Marcel-Kitzbichler/OpenMoverPlatform/Skizzen/Fahrgestell_v1.png

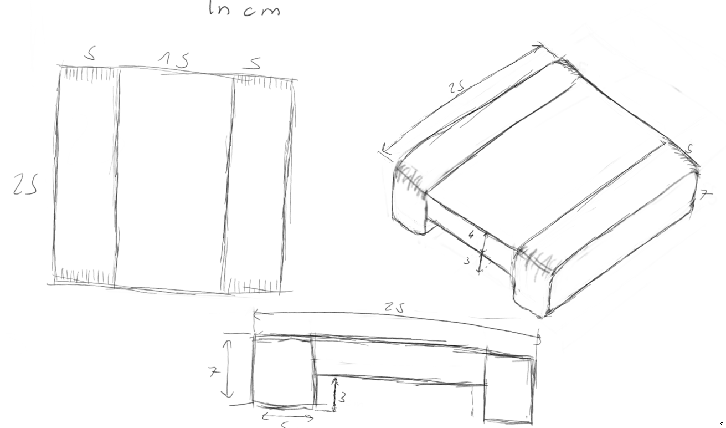
Skizzen/Fahrgestell_v1.png
