Marcel-Kitzbichler/OpenMoverPlatform/Mechanical/DRIVEUNIT_V2/UpperBearingAssembly.SLDASM

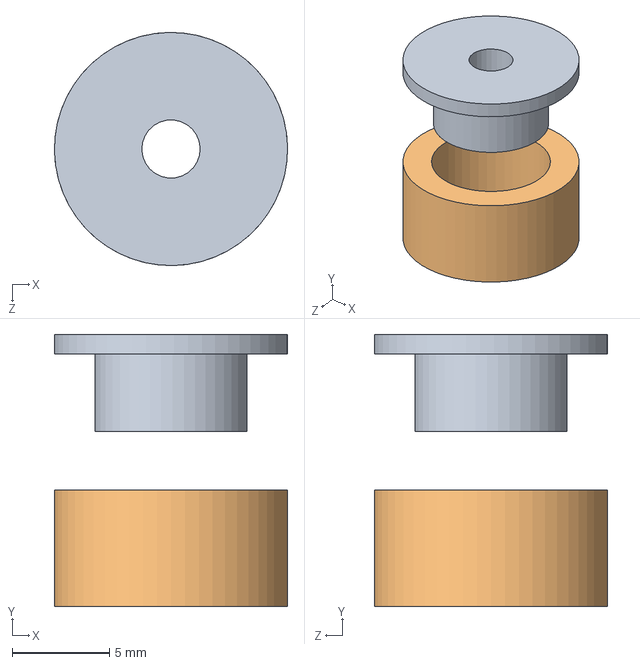
[picture p5: CAD file, 2026-01-29]
Mechanical/DRIVEUNIT_V2/UpperBearingAssembly.SLDASM
12.0 x 14.0 x 12.0 mm
UpperHolder
LowerHolder
