Marcel-Kitzbichler/OpenMoverPlatform/Mechanical/DRIVEUNIT_V2/ChainwheelAss.SLDASM

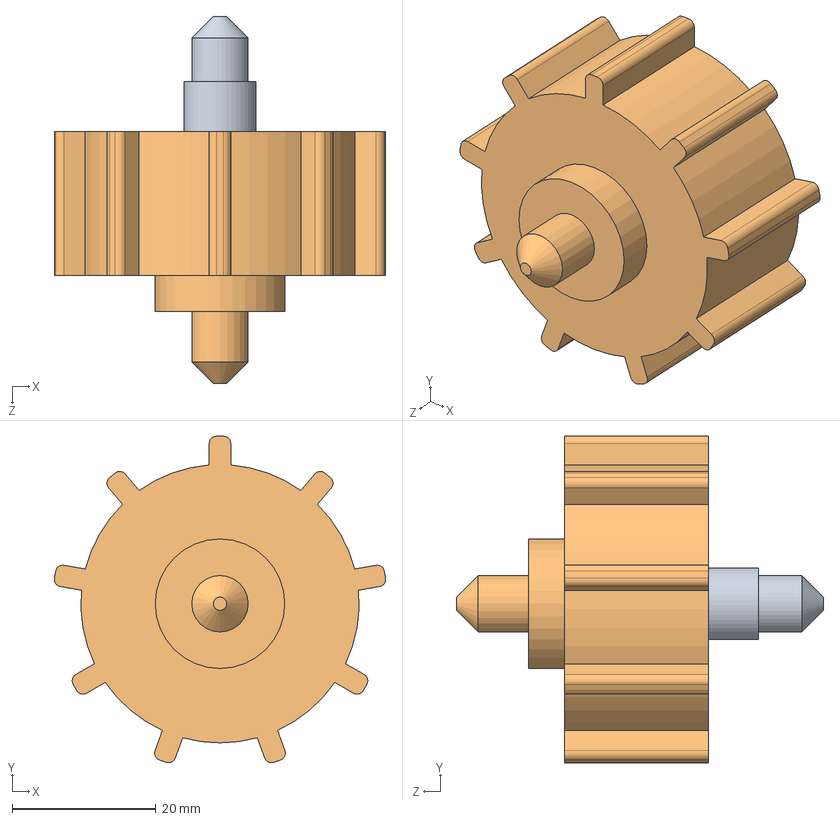
[picture p6: CAD file, 2026-01-29]
Mechanical/DRIVEUNIT_V2/ChainwheelAss.SLDASM
46.0 x 45.4 x 51.0 mm
Chainwheel
ChainAxle
