Marcel-Kitzbichler/OpenMoverPlatform/Mechanical/Assm.SLDASM

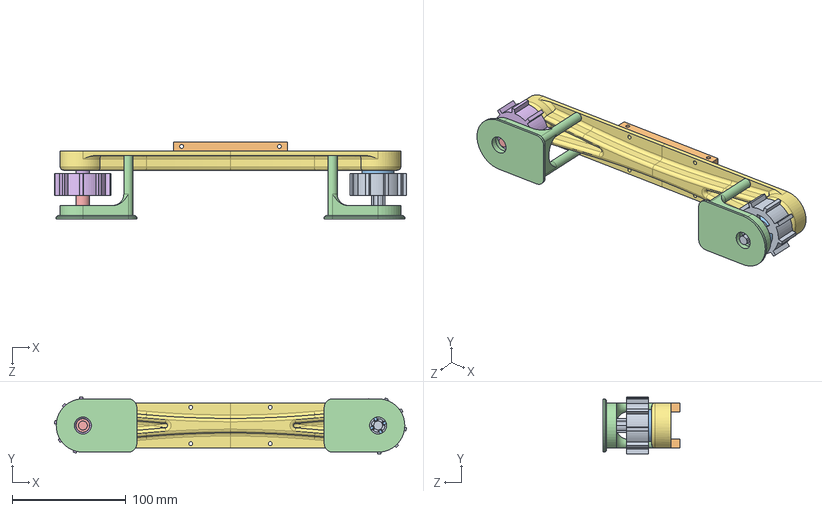
[picture p7: CAD file, 2026-01-29]
Mechanical/Assm.SLDASM
310.0 x 50.1 x 68.0 mm
Teil1
Wheel
Wheelaxle
WheelHolder x 2
MotorDummy
SideBrace x 2
Wheel_Drive
