Marcel-Kitzbichler/OpenMoverPlatform/Mechanical/Module Sample.SLDASM

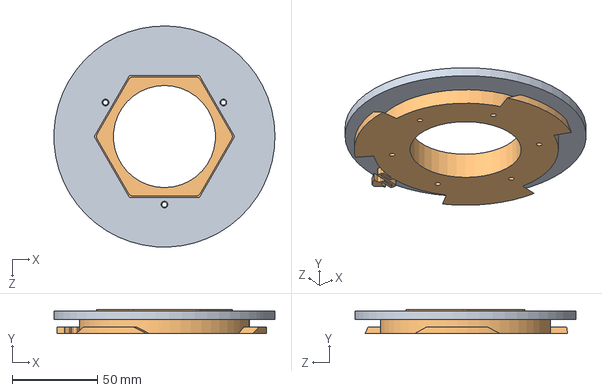
[picture p8: CAD file, 2026-01-29]
Mechanical/Module Sample.SLDASM
129.9 x 14.4 x 129.9 mm
Module Lower
Module Upper Blank
