Marcel-Kitzbichler/OpenMoverPlatform/Mechanical/DRIVEUNIT_V2/2ndWheel.SLDPRT

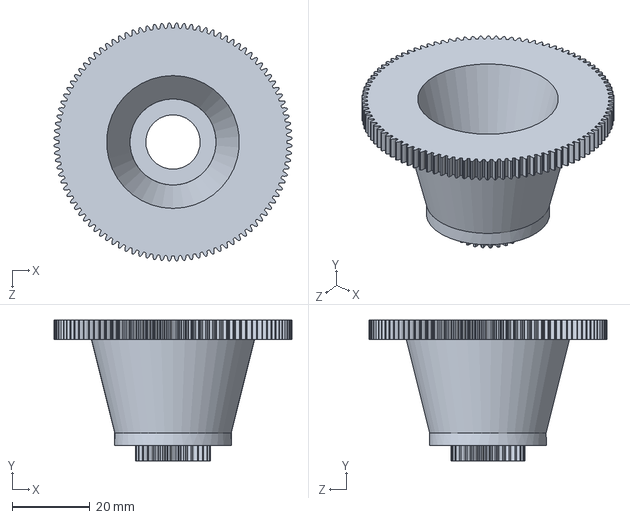
[picture p9: CAD file, 2026-01-29]
Mechanical/DRIVEUNIT_V2/2ndWheel.SLDPRT
61.2 x 36.2 x 61.2 mm
