Marcel-Kitzbichler/OpenMoverPlatform/Mechanical/Wheelaxle.SLDPRT

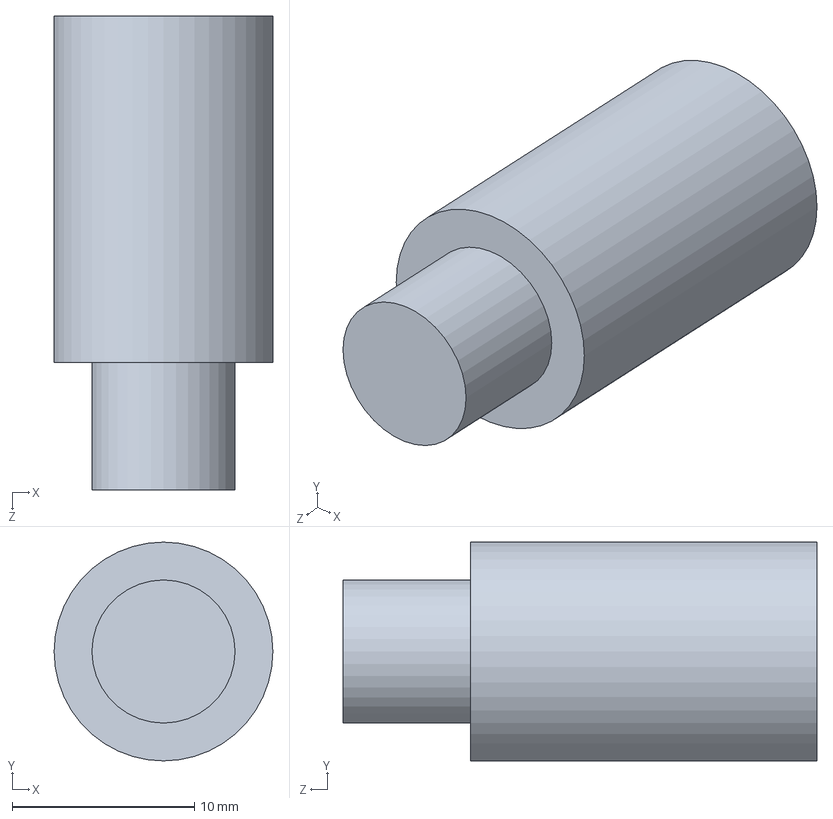
[picture p10: CAD file, 2026-01-29]
Mechanical/Wheelaxle.SLDPRT
12.0 x 12.0 x 26.0 mm
