Marcel-Kitzbichler/OpenMoverPlatform/Mechanical/DRIVEUNIT_V2/UpperHolder.SLDPRT

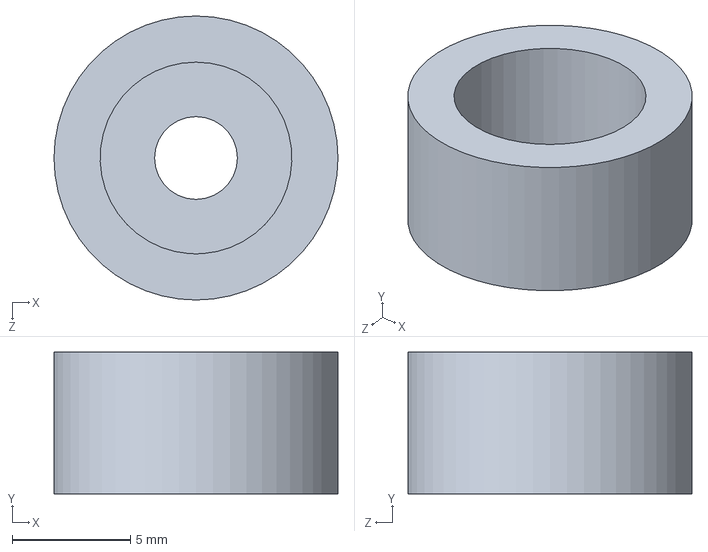
[picture p11: CAD file, 2026-01-29]
Mechanical/DRIVEUNIT_V2/UpperHolder.SLDPRT
12.0 x 6.00 x 12.0 mm
