Marcel-Kitzbichler/OpenMoverPlatform/Mechanical/Module Upper Blank.SLDPRT

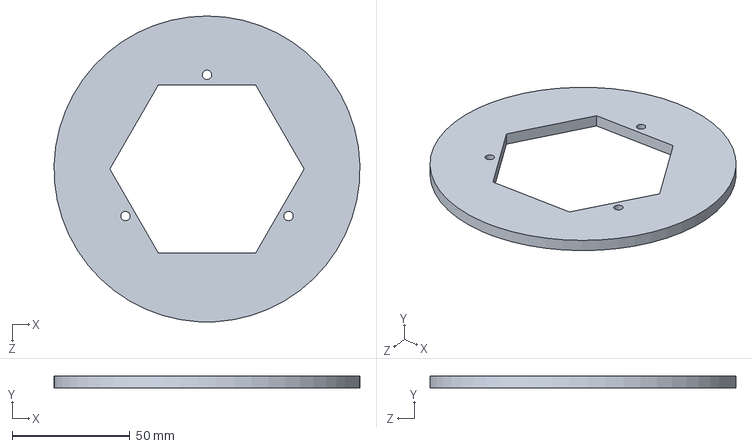
[picture p12: CAD file, 2026-01-29]
Mechanical/Module Upper Blank.SLDPRT
129.9 x 5.00 x 130.0 mm
