Marcel-Kitzbichler/OpenMoverPlatform/Mechanical/chainPresser.SLDPRT

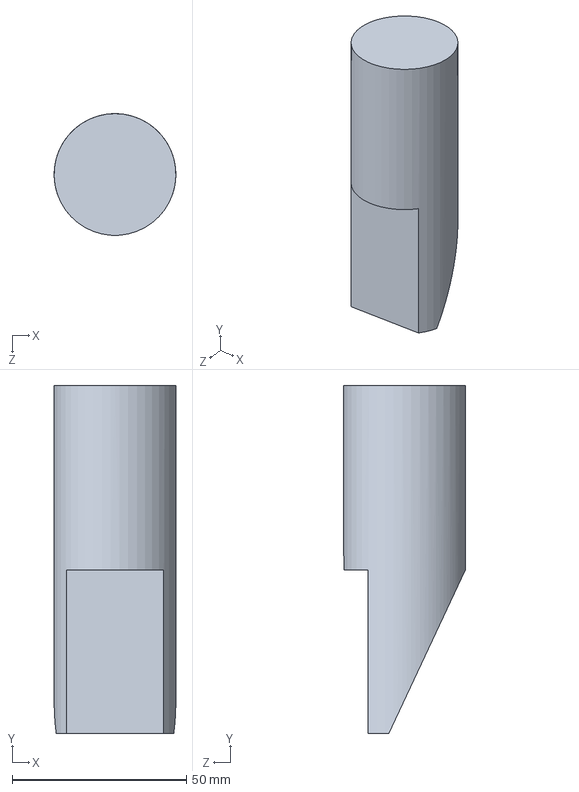
[picture p13: CAD file, 2026-01-29]
Mechanical/chainPresser.SLDPRT
35.0 x 100.0 x 35.0 mm
