Marcel-Kitzbichler/OpenMoverPlatform/Mechanical/DRIVEUNIT_V2/ChainAxle.SLDPRT

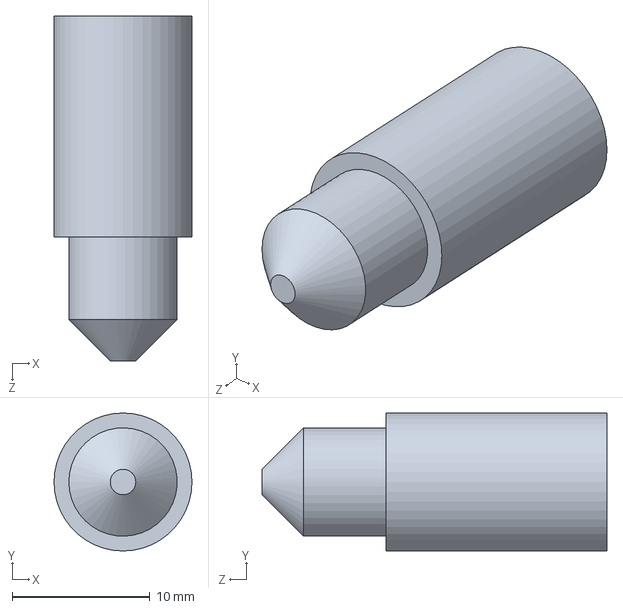
[picture p14: CAD file, 2026-01-29]
Mechanical/DRIVEUNIT_V2/ChainAxle.SLDPRT
10.0 x 10.0 x 25.0 mm
