Marcel-Kitzbichler/OpenMoverPlatform/Mechanical/DRIVEUNIT_V2/3rdGear.SLDPRT

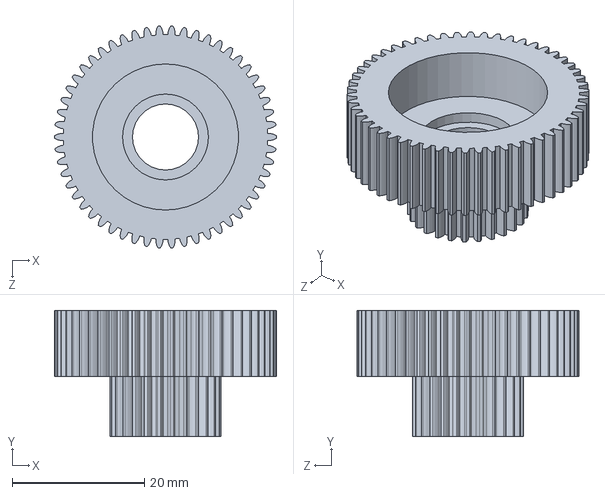
[picture p15: CAD file, 2026-01-29]
Mechanical/DRIVEUNIT_V2/3rdGear.SLDPRT
33.6 x 19.1 x 33.6 mm
