Marcel-Kitzbichler/OpenMoverPlatform/Mechanical/SideBrace.SLDPRT

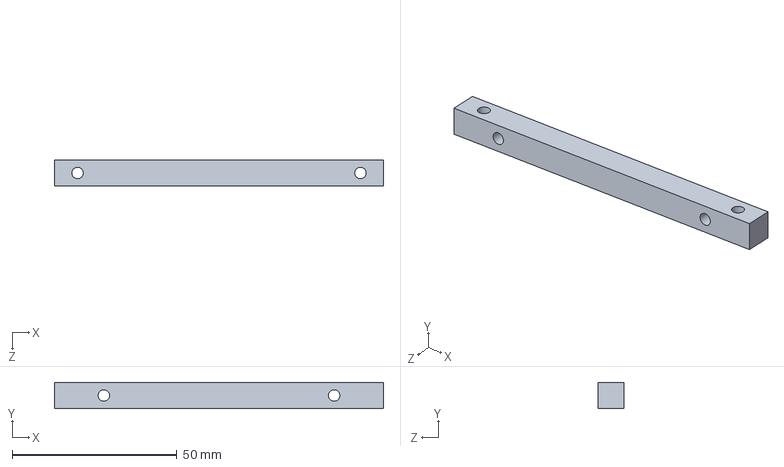
[picture p16: CAD file, 2026-01-29]
Mechanical/SideBrace.SLDPRT
100.0 x 8.00 x 8.00 mm
