Marcel-Kitzbichler/OpenMoverPlatform/Mechanical/Body2.SLDPRT

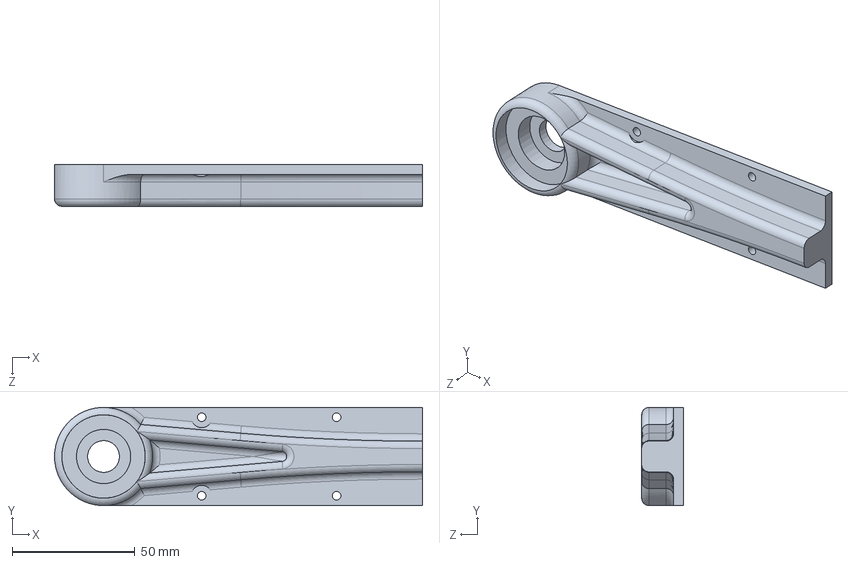
[picture p17: CAD file, 2026-01-29]
Mechanical/Body2.SLDPRT
150.0 x 40.0 x 17.0 mm
