Marcel-Kitzbichler/OpenMoverPlatform/Mechanical/DRIVEUNIT_V2/2ndGear.SLDPRT

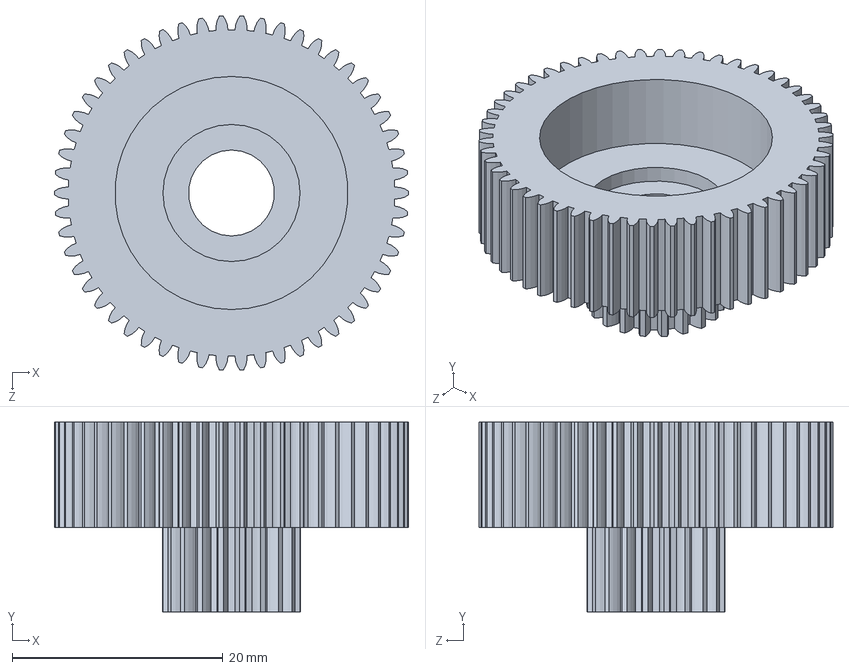
[picture p18: CAD file, 2026-01-29]
Mechanical/DRIVEUNIT_V2/2ndGear.SLDPRT
33.6 x 18.0 x 33.6 mm
