Marcel-Kitzbichler/OpenMoverPlatform/Mechanical/Cover plate.SLDPRT

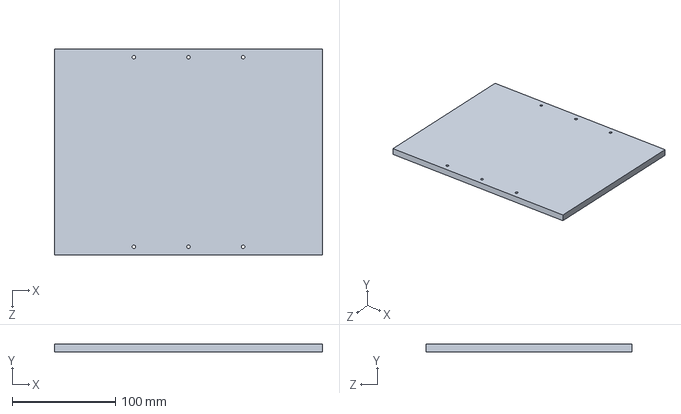
[picture p19: CAD file, 2026-01-29]
Mechanical/Cover plate.SLDPRT
260.0 x 8.00 x 200.0 mm
