Marcel-Kitzbichler/OpenMoverPlatform/Mechanical/DRIVEUNIT_V2/1stGear.SLDPRT

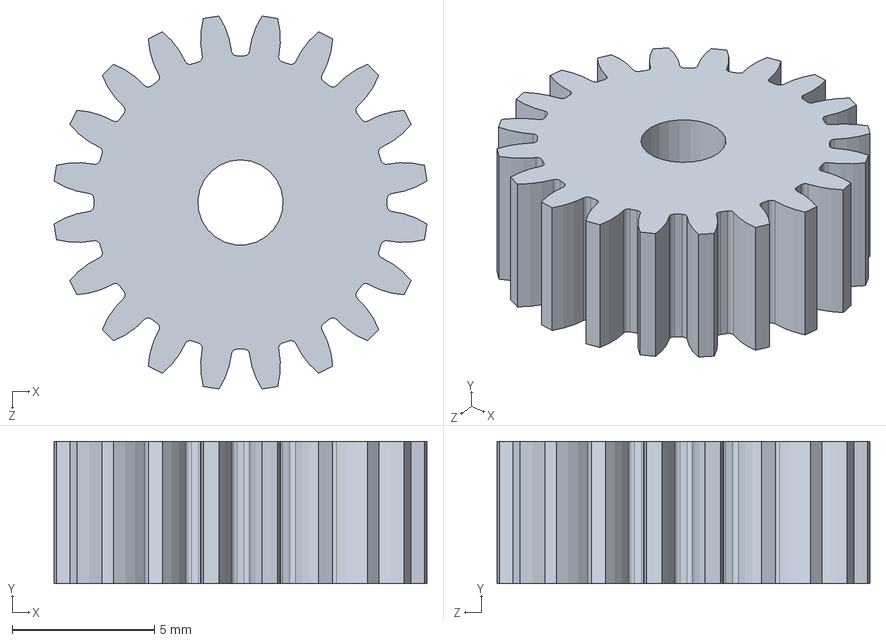
[picture p20: CAD file, 2026-01-29]
Mechanical/DRIVEUNIT_V2/1stGear.SLDPRT
13.1 x 5.00 x 13.1 mm
