Marcel-Kitzbichler/OpenMoverPlatform/Mechanical/MotorDummy.SLDPRT

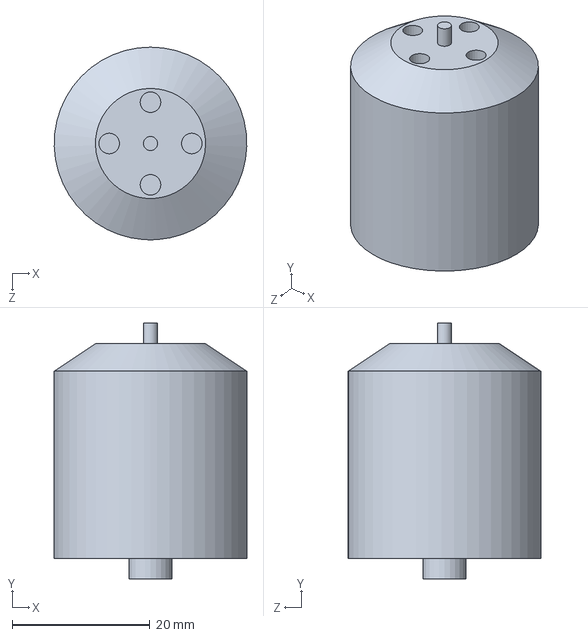
[picture p21: CAD file, 2026-01-29]
Mechanical/MotorDummy.SLDPRT
28.0 x 37.2 x 28.0 mm
