Marcel-Kitzbichler/OpenMoverPlatform/Mechanical/DRIVEUNIT_V2/Chainwheel.SLDPRT

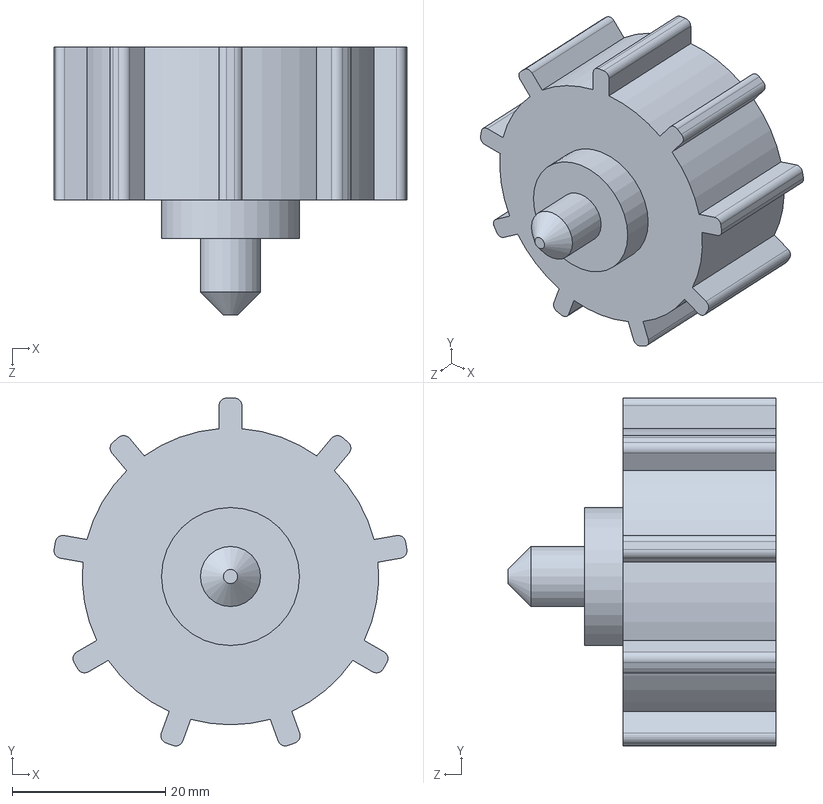
[picture p22: CAD file, 2026-01-29]
Mechanical/DRIVEUNIT_V2/Chainwheel.SLDPRT
46.0 x 45.4 x 35.0 mm
