Marcel-Kitzbichler/OpenMoverPlatform/Mechanical/Teil1.SLDPRT

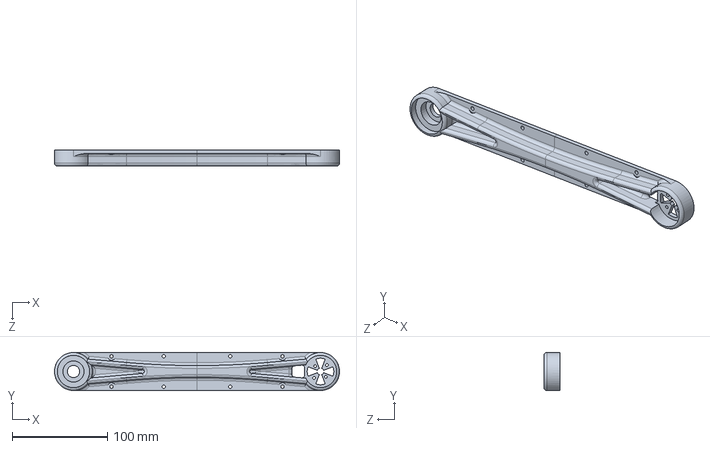
[picture p23: CAD file, 2026-01-29]
Mechanical/Teil1.SLDPRT
300.0 x 40.0 x 17.0 mm
