Marcel-Kitzbichler/OpenMoverPlatform/Mechanical/DRIVEUNIT_V2/coverplate.SLDPRT

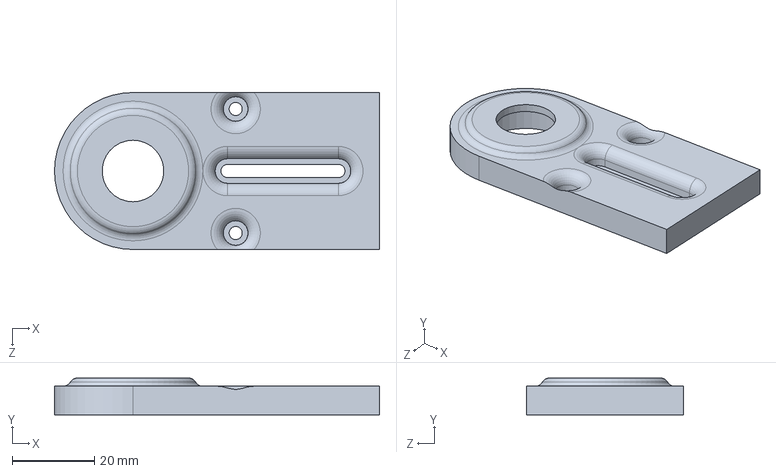
[picture p24: CAD file, 2026-01-29]
Mechanical/DRIVEUNIT_V2/coverplate.SLDPRT
79.1 x 9.00 x 38.2 mm
