Marcel-Kitzbichler/OpenMoverPlatform/Mechanical/WheelMastSupport.SLDPRT

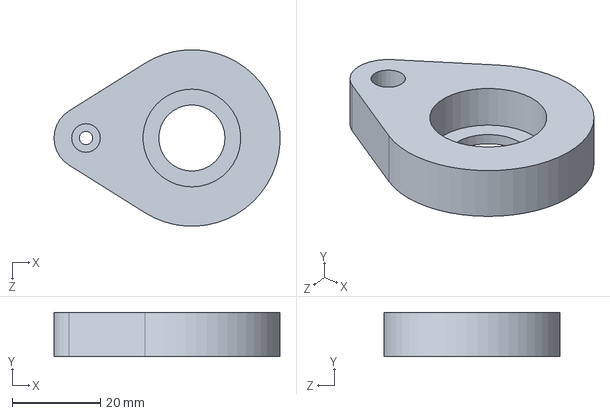
[picture p25: CAD file, 2026-01-29]
Mechanical/WheelMastSupport.SLDPRT
51.2 x 10.0 x 40.0 mm
