Marcel-Kitzbichler/OpenMoverPlatform/Mechanical/UpperPlate.SLDPRT

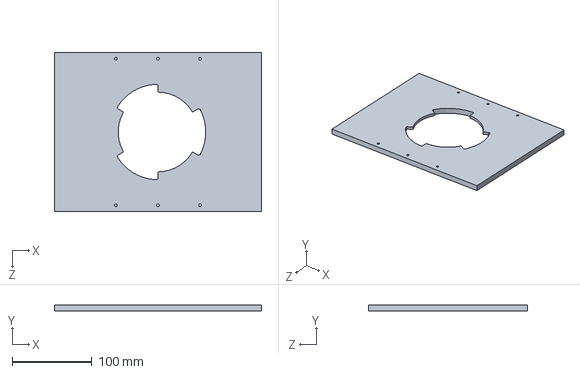
[picture p26: CAD file, 2026-01-29]
Mechanical/UpperPlate.SLDPRT
260.0 x 8.00 x 200.0 mm
