Marcel-Kitzbichler/OpenMoverPlatform/Mechanical/DRIVEUNIT_V2/Grundplatte.SLDPRT

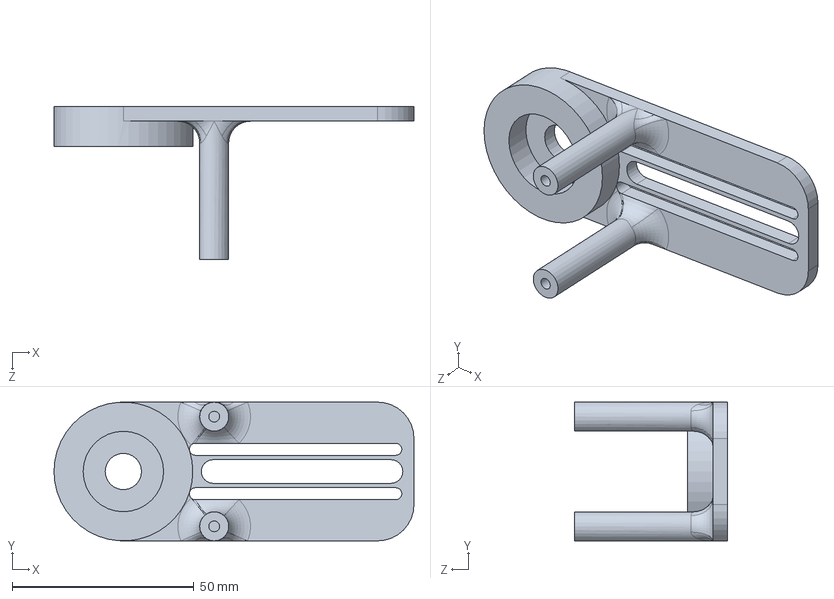
[picture p27: CAD file, 2026-01-29]
Mechanical/DRIVEUNIT_V2/Grundplatte.SLDPRT
99.1 x 38.2 x 42.0 mm
