Marcel-Kitzbichler/OpenMoverPlatform/Mechanical/DRIVEUNIT_V2/1stWheel.SLDPRT

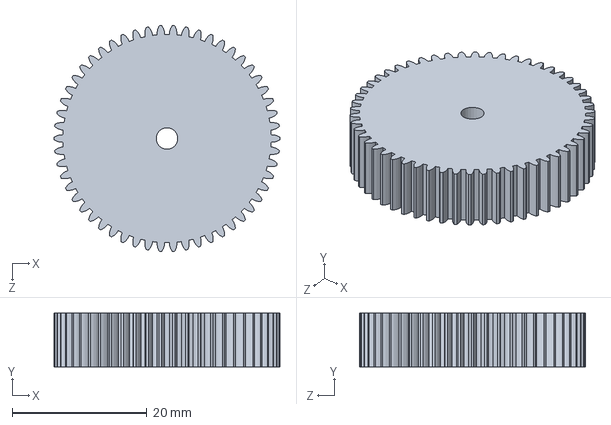
[picture p28: CAD file, 2026-01-29]
Mechanical/DRIVEUNIT_V2/1stWheel.SLDPRT
33.6 x 8.00 x 33.6 mm
