Marcel-Kitzbichler/OpenMoverPlatform/Mechanical/DRIVEUNIT_V2/FrontCover.SLDPRT

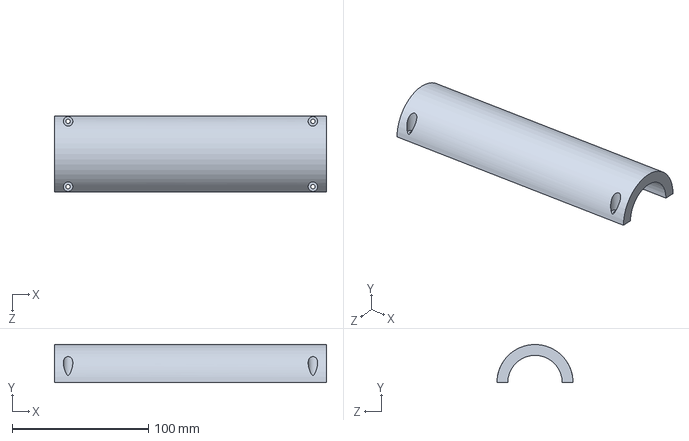
[picture p29: CAD file, 2026-01-29]
Mechanical/DRIVEUNIT_V2/FrontCover.SLDPRT
200.0 x 28.0 x 56.0 mm
