Marcel-Kitzbichler/OpenMoverPlatform/Mechanical/DRIVEUNIT_V2/LowerHolder.SLDPRT

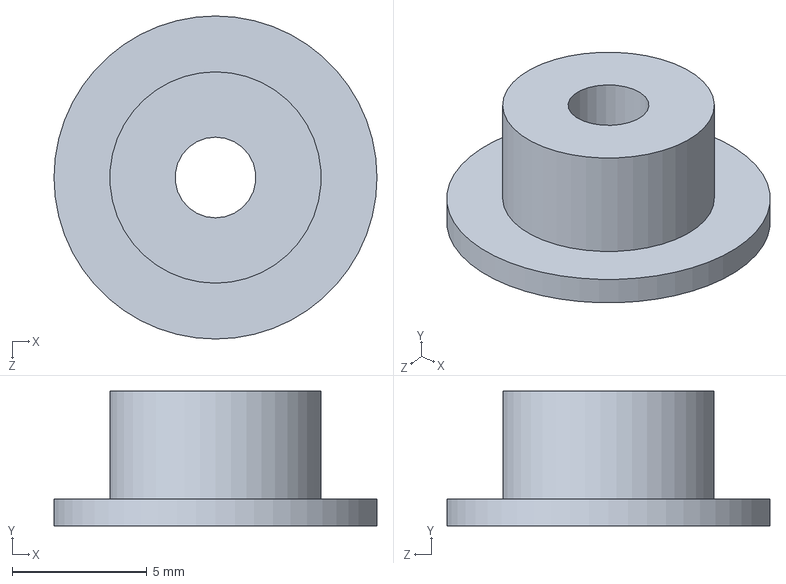
[picture p30: CAD file, 2026-01-29]
Mechanical/DRIVEUNIT_V2/LowerHolder.SLDPRT
12.0 x 5.00 x 12.0 mm
