Marcel-Kitzbichler/OpenMoverPlatform/Mechanical/WheelHolder.SLDPRT

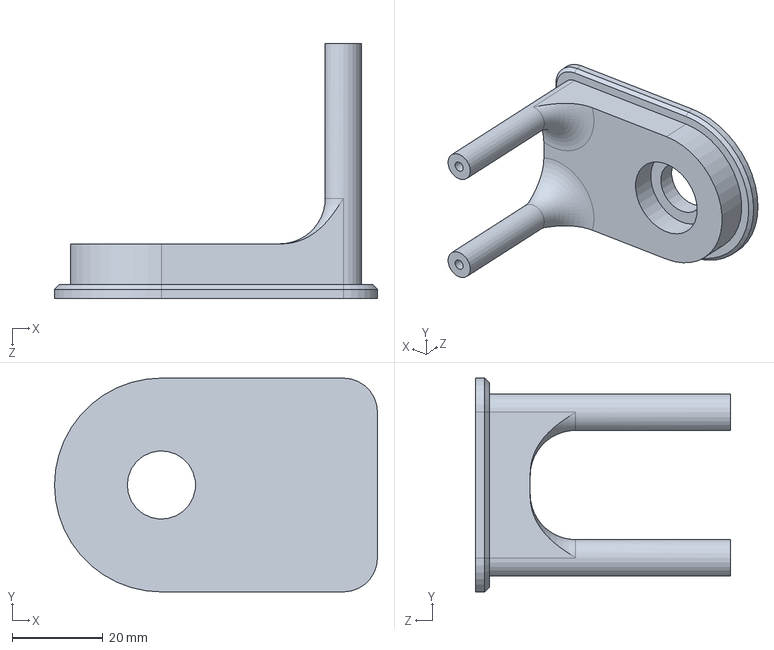
[picture p31: CAD file, 2026-01-29]
Mechanical/WheelHolder.SLDPRT
71.0 x 47.0 x 56.0 mm
