Marcel-Kitzbichler/OpenMoverPlatform/Mechanical/DRIVEUNIT_V2/Chaingear.SLDPRT

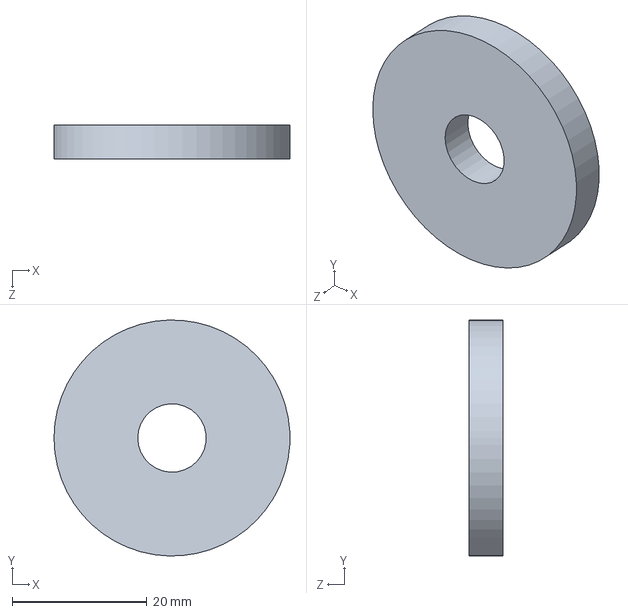
[picture p32: CAD file, 2024-11-21]
Mechanical/DRIVEUNIT_V2/Chaingear.SLDPRT
35.0 x 35.0 x 5.00 mm
