Marcel-Kitzbichler/OpenMoverPlatform/Mechanical/WheelMastStud.SLDPRT

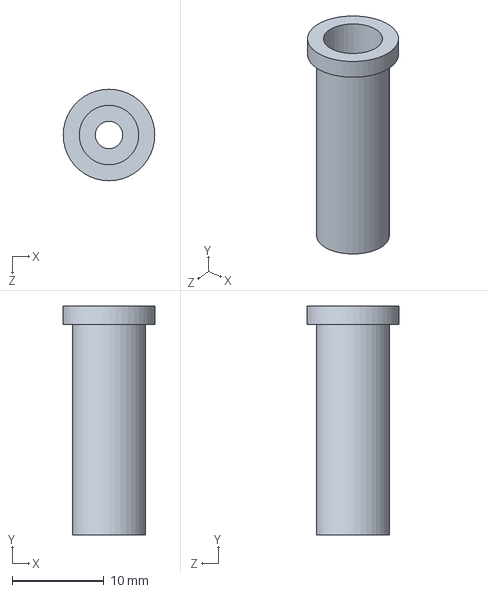
[picture p33: CAD file, 2026-01-29]
Mechanical/WheelMastStud.SLDPRT
10.0 x 25.0 x 10.0 mm
