Marcel-Kitzbichler/OpenMoverPlatform/Mechanical/Wheel.SLDPRT

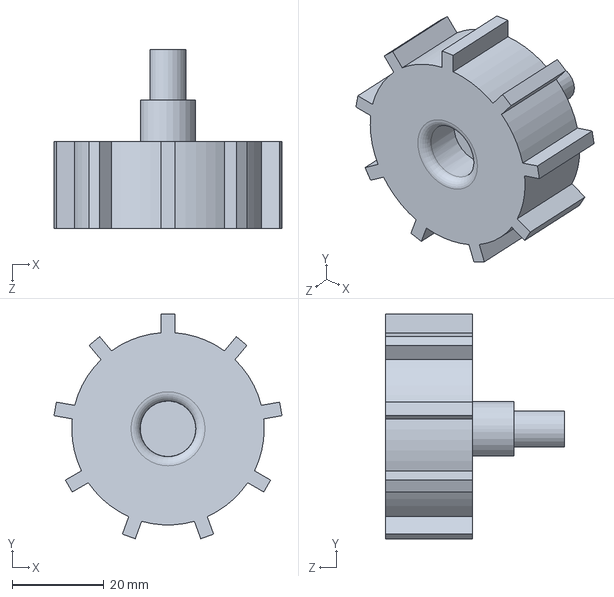
[picture p34: CAD file, 2026-01-29]
Mechanical/Wheel.SLDPRT
49.8 x 49.0 x 39.0 mm
