Marcel-Kitzbichler/OpenMoverPlatform/Mechanical/WheelMast.SLDPRT

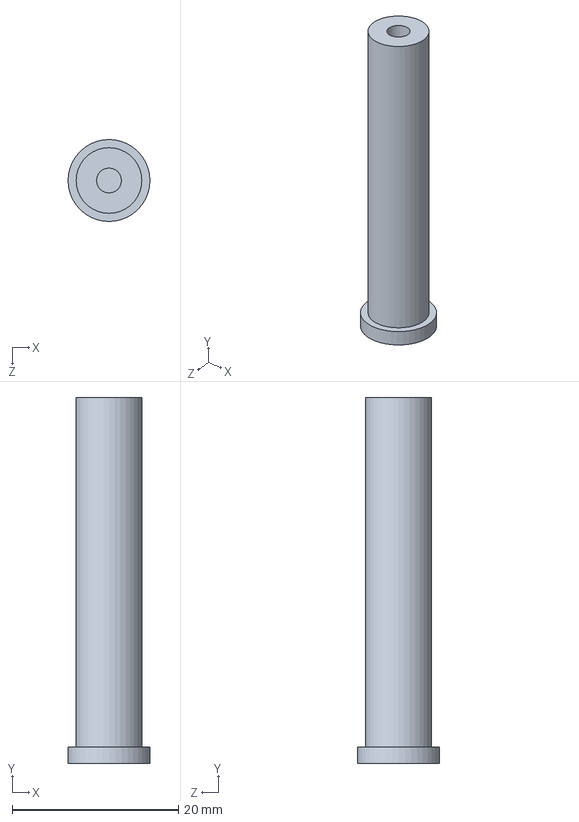
[picture p35: CAD file, 2026-01-29]
Mechanical/WheelMast.SLDPRT
9.85 x 44.0 x 9.85 mm
