Marcel-Kitzbichler/OpenMoverPlatform/Mechanical/Wheel_Drive.SLDPRT

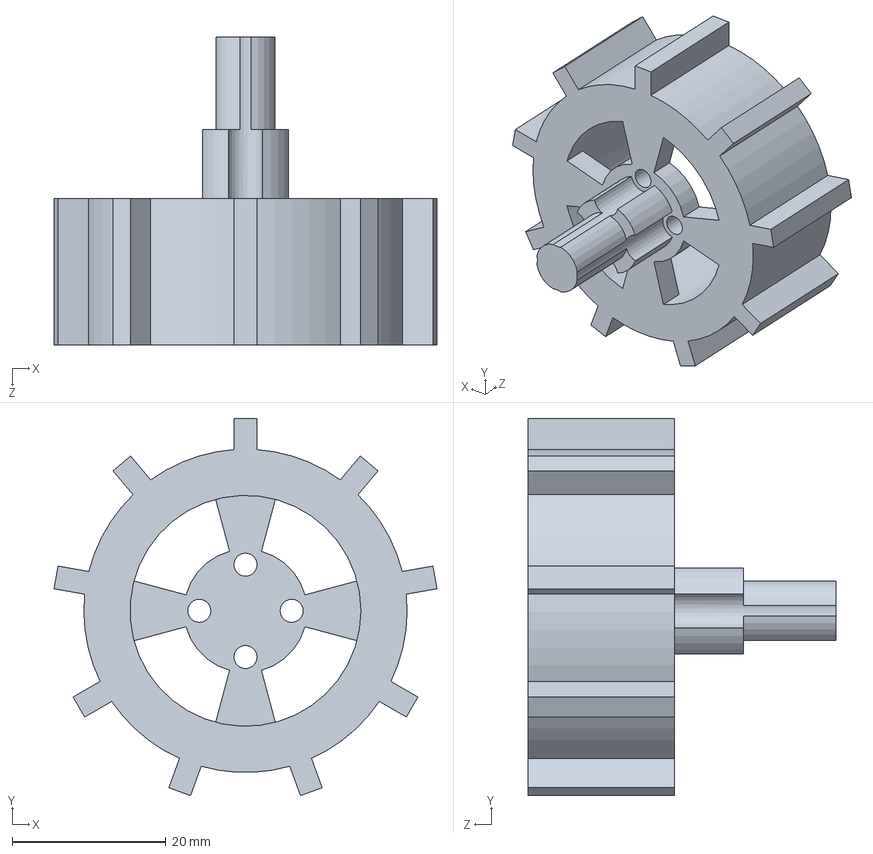
[picture p36: CAD file, 2026-01-29]
Mechanical/Wheel_Drive.SLDPRT
49.8 x 49.0 x 40.0 mm
