Marcel-Kitzbichler/OpenMoverPlatform/Mechanical/Module Lower.SLDPRT

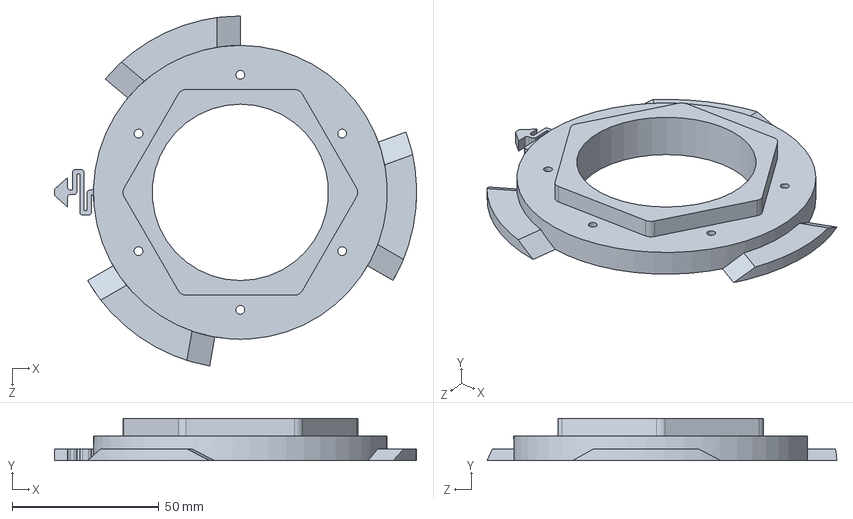
[picture p37: CAD file, 2025-05-10]
Mechanical/Module Lower.SLDPRT
123.3 x 14.4 x 119.1 mm
