Marcel-Kitzbichler/OpenMoverPlatform/Mechanical/Panzerketten 2.SLDPRT

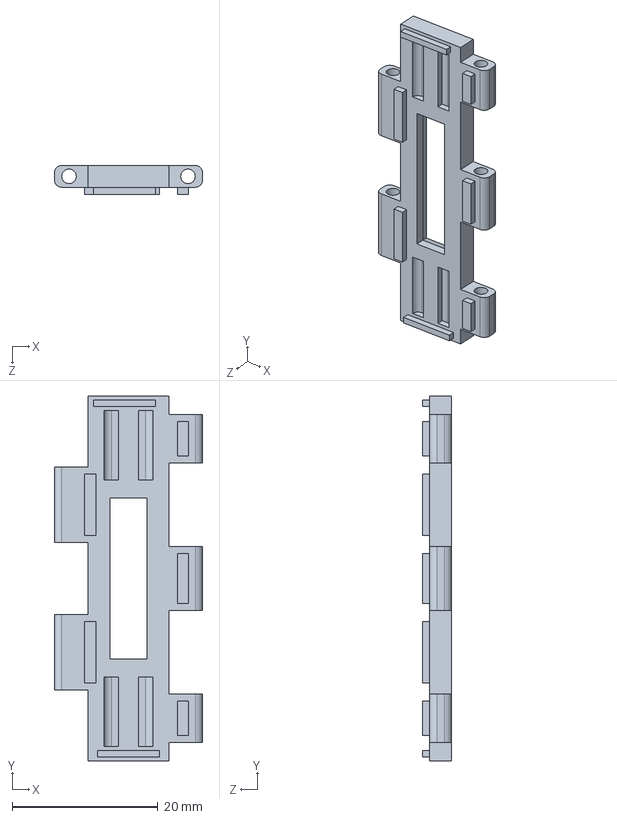
[picture p38: CAD file, 2025-02-27]
Mechanical/Panzerketten 2.SLDPRT
20.3 x 50.0 x 4.00 mm
