Marcel-Kitzbichler/OpenMoverPlatform/Mechanical/threadedRodM3x210.SLDPRT

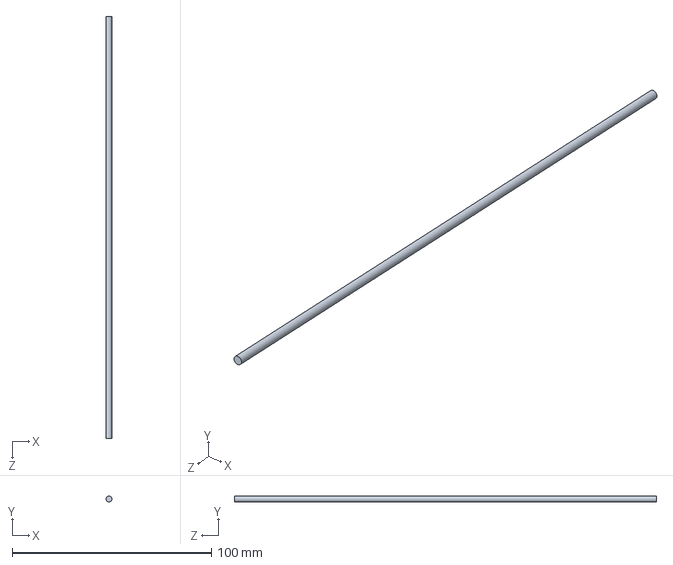
[picture p39: CAD file, 2025-01-20]
Mechanical/threadedRodM3x210.SLDPRT
3.00 x 3.00 x 212.0 mm
