Marcel-Kitzbichler/OpenMoverPlatform/Mechanical/3rdWheel.SLDPRT

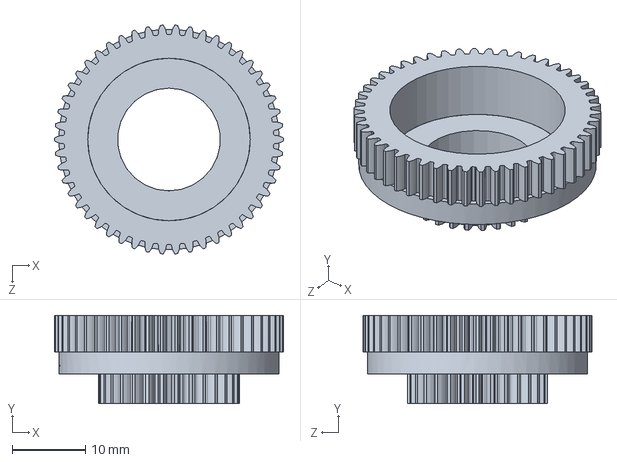
[picture p40: CAD file, 2024-12-03]
Mechanical/3rdWheel.SLDPRT
31.2 x 12.0 x 31.2 mm
