Marcel-Kitzbichler/OpenMoverPlatform/Mechanical/DRIVEUNIT_V2/Assembly.SLDASM

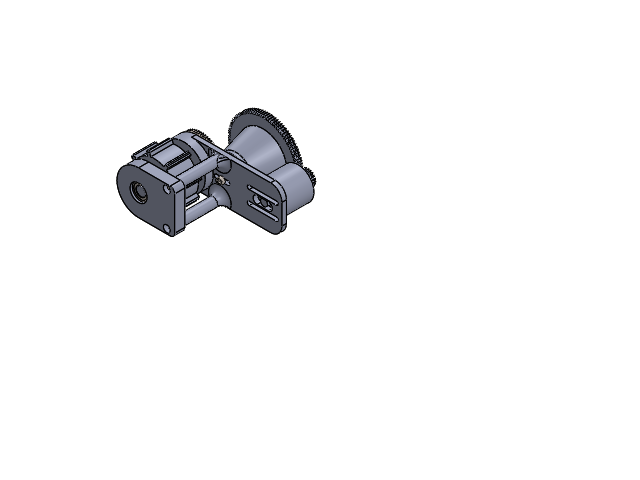
[picture p41: CAD file, 2026-01-29]
Mechanical/DRIVEUNIT_V2/Assembly.SLDASM
Grundplatte
radial ball bearing_68_din x 3
Chainwheel
ChainAxle
coverplate
UpperHolder
LowerHolder
spur gear_din
2ndWheel
MotorDummy
1stGear
socket head cap screw_din x 3
