Marcel-Kitzbichler/OpenMoverPlatform/Mechanical/AssmFull.SLDASM

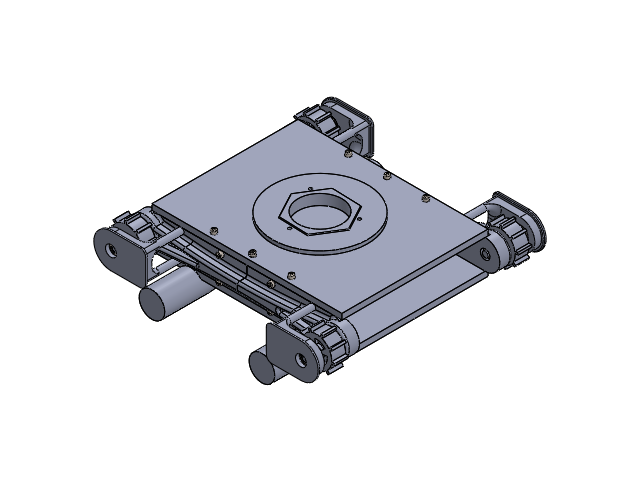
[picture p42: CAD file, 2026-01-29]
Mechanical/AssmFull.SLDASM
Cover plate
Teil1 x 2
Wheel x 2
Wheelaxle x 2
radial ball bearing_68_din x 6
WheelHolder x 4
MotorDummy x 2
SideBrace x 4
Wheel_Drive x 2
chainPresser x 4
UpperPlate
socket head cap screw_din x 29
Module Lower
Module Upper Blank
