Marcel-Kitzbichler/OpenMoverPlatform/Mechanical/Wheelasm.SLDASM

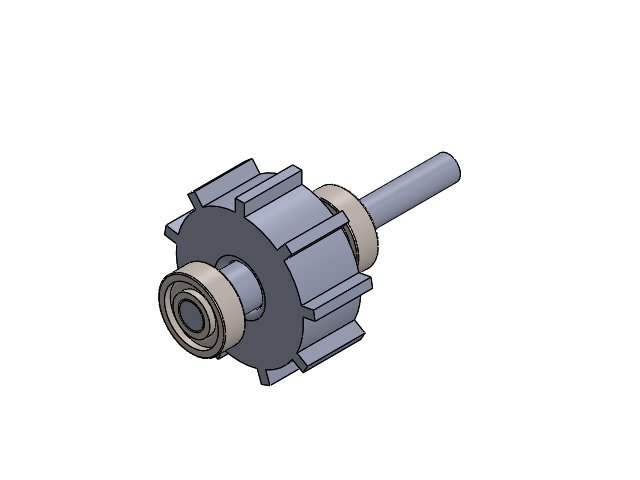
[picture p43: CAD file, 2026-01-29]
Mechanical/Wheelasm.SLDASM
Wheel
Wheelaxle
radial ball bearing_68_din x 2
