Marcel-Kitzbichler/OpenMoverPlatform/(list of files, cad)

Other CAD files:
Mechanical/mountedBearing.SLDASM
Mechanical/Body1.SLDPRT
Mechanical/UpperHolder.SLDPRT
Mechanical/LowerHolder.SLDPRT
Mechanical/DRIVEUNIT_V1/Abdeckplatte.SLDPRT
Mechanical/DRIVEUNIT_V1/Baugr1.SLDASM
Mechanical/DRIVEUNIT_V1/Mittelplatte.SLDPRT
Mechanical/DRIVEUNIT_V1/Motorplatte.SLDPRT
Mechanical/DRIVEUNIT_V1/RadCover.SLDPRT
Mechanical/DRIVEUNIT_V1/Spacer.SLDPRT
Mechanical/DRIVEUNIT_V1/Spacer20_5mm.SLDPRT
Mechanical/DRIVEUNIT_V1/TEST!!RAD.SLDPRT
Mechanical/DRIVEUNIT_V1/internal spur gear_din.SLDPRT
Mechanical/DRIVEUNIT_V1/meshes/driveUnit - Abdeckplatte-1.STL
Mechanical/DRIVEUNIT_V1/meshes/driveUnit - Mittelplatte-1.STL
Mechanical/DRIVEUNIT_V1/meshes/driveUnit - Motorplatte-2.STL
Mechanical/DRIVEUNIT_V1/meshes/driveUnit - Spacer-1.STL
Mechanical/DRIVEUNIT_V1/meshes/driveUnit - Spacer-2.STL
Mechanical/DRIVEUNIT_V1/meshes/driveUnit - TEST!!RAD-1.STL
Mechanical/DRIVEUNIT_V1/meshes/driveUnit - internal spur gear_din-1.STL
Mechanical/DRIVEUNIT_V1/meshes/driveUnit - spur gear_din-1.STL
Mechanical/DRIVEUNIT_V1/meshes/driveUnit - spur gear_din-2.STL
Mechanical/DRIVEUNIT_V1/meshes/driveUnit - spur gear_din-3.STL
Mechanical/DRIVEUNIT_V1/meshes/driveUnit - spur gear_din-4.STL
Mechanical/DRIVEUNIT_V1/meshes/driveUnit - spur gear_din-5.STL
Mechanical/DRIVEUNIT_V1/meshes/driveUnit - spur gear_din-7.STL
Mechanical/DRIVEUNIT_V1/spur gear_din_shaft.SLDPRT
Mechanical/FrontCover.SLDDRW
