Marcel-Kitzbichler/OpenMoverPlatform/PlatformCode/PlatformHelper/CHANGELOG.md

# Changelog - Platform Helper Tools

## Version 2.0 - Enhanced Release (December 2024)

### 🎉 Major Features Added

#### 1. Modern GUI Application (`helper_gui.py`)
- **Tabbed Interface**: Six organized tabs for different functions
  - Connection: Serial port management
  - Status: Real-time platform monitoring
  - Motor Control: Direct motor control with sliders
  - Waypoints: Route planning and navigation
  - Compass: Magnetometer calibration and logging
  - Console Log: Communication history
  
- **Real-time Monitoring**: Auto-refresh status at 1-second intervals
  - Battery voltage
  - GPS status (satellites, fix, coordinates, age)
  - Compass heading
  - Motor states and setpoints
  - Magnetometer calibration values

- **Visual Controls**:
  - Motor PWM sliders (-255 to 255)
  - KML file browser
  - One-click operations
  - Color-coded connection status

- **Advanced Features**:
  - Background threading for non-blocking operations
  - Magnetometer data logging with start/stop
  - Comprehensive console logging
  - Error handling and user feedback

#### 2. Enhanced CLI Application (`helper_cli.py`)
- **Complete Intent Coverage**: All 10 intents now accessible
  - Intent 1: Get stored coordinates
  - Intent 2: Execute waypoint navigation
  - Intent 3: Set motor control mode
  - Intent 4: Direct motor control
  - Intent 5: Upload coordinates from KML
  - Intent 6: Get platform status (comprehensive)
  - Intent 7: Go to single coordinate
  - Intent 8: Calibrate compass
  - Intent 9: Log magnetometer data
  - Intent 10: Set motor bias

- **Improved Usability**:
  - Menu-driven interface
  - Command-line argument support
  - Better error messages
  - Formatted status output
  - Keyboard interrupt handling

- **Backward Compatible**: Can be used as drop-in replacement for legacy tool

#### 3. Comprehensive Documentation
- **README.md** (5.7 KB):
  - Full protocol specification
  - All 10 intents documented with examples
  - KML format specification
  - Installation instructions
  - Troubleshooting guide

- **USAGE_EXAMPLES.md** (6.8 KB):
  - 8 detailed usage scenarios
  - Complete workflows (e.g., autonomous navigation)
  - Tips and best practices
  - Problem-solution examples
  - Integration guide for custom applications
  - Safety reminders

- **QUICK_REFERENCE.md** (4.0 KB):
  - Quick start commands
  - Intent reference table
  - Parameter guidelines
  - Safety checklist
  - Troubleshooting quick-fixes
  - Pro tips

- **ARCHITECTURE.md** (15 KB):
  - System overview diagrams
  - Communication protocol flow
  - Data flow examples
  - Class/module responsibilities
  - Threading model
  - Extension points
  - File structure
  - Future enhancement ideas

### 🔧 Technical Improvements

#### Code Quality
- Proper error handling throughout
- Type-safe formatting for GPS and sensor data
- Integer division for coordinate counting
- Clean separation of concerns
- Threading for non-blocking GUI operations

#### Dependencies
- `requirements.txt` added with minimal dependencies
- Only requires `pyserial>=3.5`
- GUI uses built-in tkinter (no additional install needed on most systems)

#### Project Structure
- Updated `.gitignore` with Python-specific entries
  - `__pycache__/`
  - `*.pyc`, `*.pyo`
  - Virtual environments
  - Build artifacts

### 📊 Statistics

**New Files Created**: 7
- `helper_gui.py` (26 KB, 680+ lines)
- `helper_cli.py` (11 KB, 315+ lines)
- `README.md` (5.7 KB)
- `USAGE_EXAMPLES.md` (6.8 KB)
- `QUICK_REFERENCE.md` (4.0 KB)
- `ARCHITECTURE.md` (15 KB)
- `requirements.txt` (13 bytes)

**Files Modified**: 1
- `.gitignore` (added Python entries)

**Total Lines Added**: ~2,000+
**Total Documentation**: ~30 KB

### 🔒 Security

- ✅ CodeQL security scan: **0 alerts**
- ✅ Code review: All issues resolved
- Serial communication validated
- No hardcoded credentials
- Safe JSON parsing with error handling

### 🐛 Bug Fixes

- Fixed integer division for coordinate counting
- Added type checking before formatting GPS coordinates
- Removed trailing newline in requirements.txt
- Improved error handling for missing/invalid data

### ⚙️ Compatibility

**Python Versions**: 3.7+
**Tested On**:
- Python 3.12.3
- pyserial 3.5

**Platform Firmware**: Compatible with all existing firmware versions
**Backward Compatibility**: Original `helper.py` preserved and functional

### 🎯 Usage Comparison

| Feature | Legacy (helper.py) | Enhanced CLI | Modern GUI |
|---|---|---|---|
| Intents Supported | 2 (5, 9) | 10 (all) | 10 (all) |
| Interface | Basic CLI | Menu CLI | Graphical |
| Real-time Status | No | Manual | Auto-refresh |
| Motor Control | No | Yes | Visual sliders |
| Waypoint Upload | Yes | Yes | File browser |
| Compass Calibration | No | Yes | Yes |
| Data Logging | Yes | Yes | Yes |
| Status Monitoring | No | Yes | Dashboard |
| User-Friendly | Basic | Good | Excellent |

### 📝 Migration Guide

**From Legacy to Enhanced CLI**:
```bash
# Old way
python helper.py

# New way (same functionality + more)
python helper_cli.py
```

**From CLI to GUI**:
```bash
# Instead of command-line menus
python helper_gui.py
# Then use visual interface
```

**All three tools can coexist** - choose based on your needs:
- Use **helper.py** for quick uploads (legacy scripts)
- Use **helper_cli.py** for scripting and automation
- Use **helper_gui.py** for interactive operation and monitoring

### 🚀 Getting Started

```bash
# Install dependencies
pip install -r requirements.txt

# Launch GUI (recommended for new users)
python helper_gui.py

# Or launch enhanced CLI
python helper_cli.py /dev/ttyUSB0

# Or use legacy tool (still works)
python helper.py
```

### 🎓 Learning Resources

1. Start with **QUICK_REFERENCE.md** for basic commands
2. Review **USAGE_EXAMPLES.md** for detailed scenarios
3. Consult **README.md** for protocol details
4. Check **ARCHITECTURE.md** for system design

### 🙏 Acknowledgments

- Original `helper.py` design and `parsekml.py` module
- Serial protocol implementation in `serialManager.cpp`
- Community feedback and requirements

### 📋 Future Enhancements

Potential additions for future versions:
- Web-based interface
- Mobile app companion
- Telemetry recording and replay
- Offline map display
- Mission scripting language
- Multi-platform control
- Data visualization and plotting
- Path planning with obstacle avoidance

### 🐛 Known Limitations

- GUI requires tkinter (not installed by default on some minimal Linux)
- Serial timeout set to 2 seconds (may need adjustment for slow responses)
- No automatic reconnection on serial disconnect
- KML parser expects specific Google Earth format

### 📞 Support

- See documentation files for detailed help
- Check existing GitHub issues
- Report bugs via GitHub issues
- Contribute improvements via pull requests

---

**Note**: This changelog covers the enhancement from basic 2-intent tool to full-featured GUI/CLI applications with complete protocol support.
