Marcel-Kitzbichler/OpenMoverPlatform/Electrical/OpenMoverPlatform/OpenMoverPlatform.kicad_pcb

## KiCad design Electrical/OpenMoverPlatform/OpenMoverPlatform.kicad_pcb (2026-01-29)

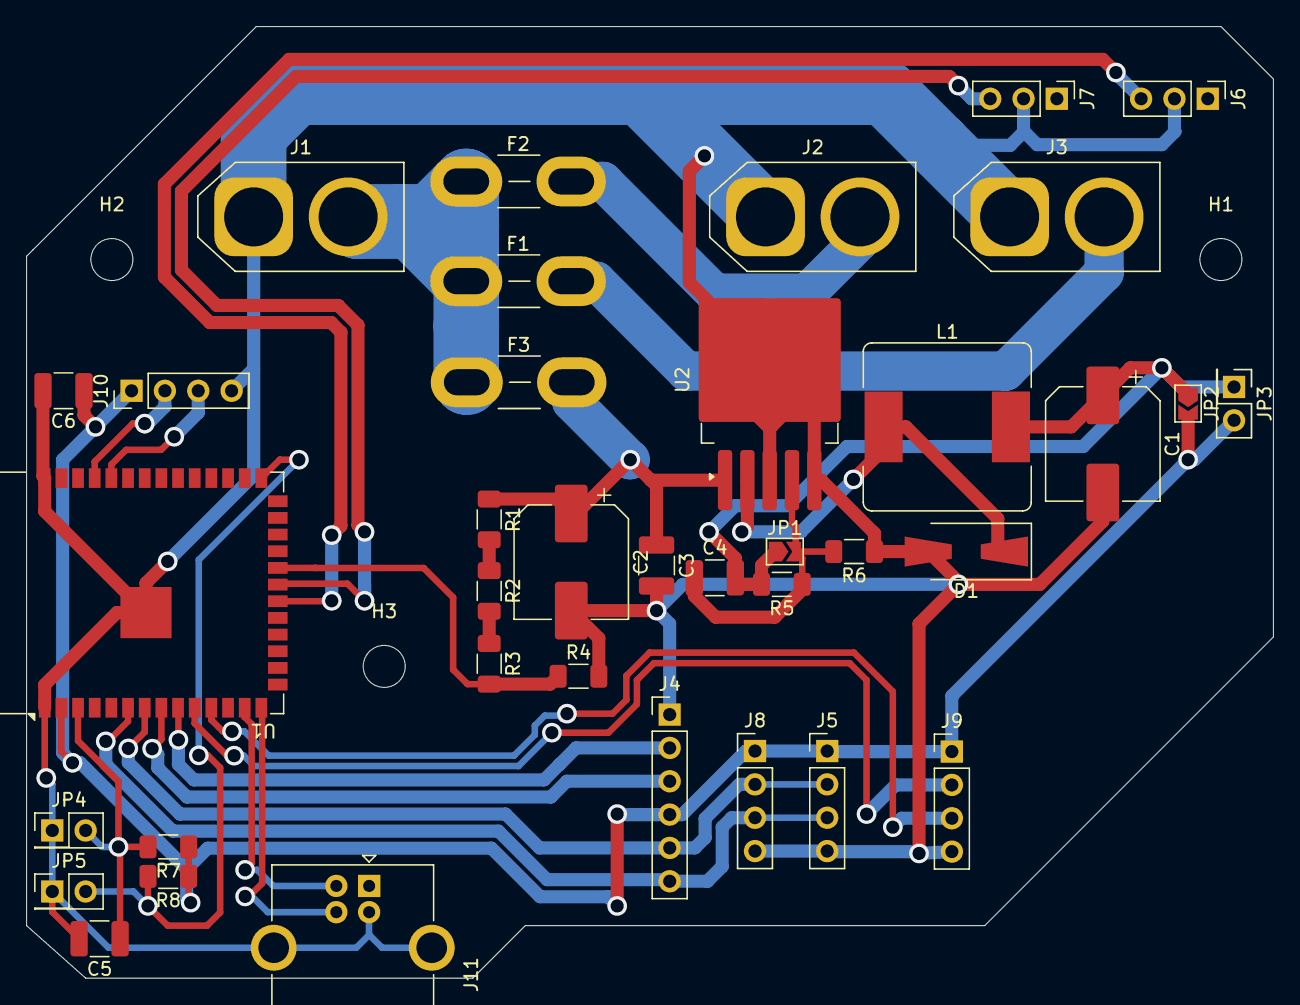
[picture p44: board OpenMoverPlatform.kicad_pcb from above]

Board: 2 copper layers, 95.0 x 72.5 mm, 40 parts (0 on the bottom side), 26 nets.

Parts:
C1: C_Polarized; CP_Elec_8x10.5
C2: C; CP_Elec_8x10.5
C3, C4, C5, C6: C; C_1210_3225Metric_Pad1.33x2.70mm_HandSolder
D1: D_Schottky; D_SMA-SMB_Universal_Handsoldering
F1, F2, F3: Fuse; Fuse_Blade_Mini_directSolder
H1, H2, H3: MountingHole; MountingHole_3.2mm_M3
J1: battery supply; AMASS_XT60-M_1x02_P7.20mm_Vertical
J2: BLDC1 POWER; AMASS_XT60-F_1x02_P7.20mm_Vertical
J3: BLDC2 POWER; AMASS_XT60-F_1x02_P7.20mm_Vertical
J4: GPS_MAG; PinHeader_1x06_P2.54mm_Vertical
J5: I2C_1; PinHeader_1x04_P2.54mm_Vertical
J6: BLDC1 PWM; PinHeader_1x03_P2.54mm_Vertical
J7: BLDC2 PWM; PinHeader_1x03_P2.54mm_Vertical
J8: I2C_2; PinHeader_1x04_P2.54mm_Vertical
J9: MOD_SERIAL; PinHeader_1x04_P2.54mm_Vertical
J10: SERIAL0; PinHeader_1x04_P2.54mm_Vertical
J11: USB_B; USB_B_OST_USB-B1HSxx_Horizontal
JP1: Regulator Adj; SolderJumper-2_P1.3mm_Open_TrianglePad1.0x1.5mm
JP2: 3V3_Disconnect; SolderJumper-2_P1.3mm_Open_TrianglePad1.0x1.5mm
JP3: 3V3_Disconnect_B; PinHeader_2x01_P2.54mm_Vertical
JP4: Reset; PinHeader_2x01_P2.54mm_Vertical
JP5: Boot; PinHeader_2x01_P2.54mm_Vertical
L1: L; L_Bourns_SRR1260
R1, R2, R3, R4, R5, R6, R7, R8: R; R_1206_3216Metric_Pad1.30x1.75mm_HandSolder
U1: ESP32-S3-WROOM-1
U2: LM2596S-ADJ; TO-263-5_TabPin3

Connections:
+3V3: C6.1, J4.4, J5.1, J8.1, J9.1, J10.1, JP2.2 (B), JP3.2 (B), R7.1, R8.1, U1.2 (3V3)
+BATT: C2.1, C3.1, F3.2, R1.1, U2.1 (VIN)
EN: C5.1, JP4.2 (B), R7.2, U1.3 (EN)
GND: C1.2, C2.2, C3.2, C5.2, C6.2, D1.2 (A), J1.1, J2.1, J3.1, J4.1, J5.4, J6.2, J7.2, J8.4, J9.4, J10.4, J11.4 (GND), J11.5 (Shield), JP4.1 (A), JP5.1 (A), R4.2, R6.1, U1.1 (GND), U1.40 (GND), U1.41 (GND), U2.3 (GND), U2.5 (~ON/OFF)
IO0: JP5.2 (B), R8.2, U1.27 (IO0)
IO6_SCL: J4.6, J5.3, J8.3, U1.6 (IO6)
IO7_SDA: J4.5, J5.2, J8.2, U1.7 (IO7)
IO12_PWM1: J6.3, U1.20 (IO12)
IO13_PWM2: J7.3, U1.21 (IO13)
IO14_BatADC: R3.2, R4.1, U1.22 (IO14)
IO15_TXGPS: J4.3, U1.8 (IO15)
IO16_RXGPS: J4.2, U1.9 (IO16)
IO17_TXMOD: J9.2, U1.10 (IO17)
IO18_RXMOD: J9.3, U1.11 (IO18)
IO19_D-: J11.2 (D-), U1.13 (IO19)
IO20_D+: J11.3 (D+), U1.14 (IO20)
unnamed: D1.1 (K), L1.1, U2.2 (OUT)
unnamed: F1.1, F2.1, F3.1, J1.2
unnamed: F2.2, J2.2
unnamed: F1.2, J3.2
unnamed: C1.1, C4.2, JP1.1 (A), JP2.1 (A), JP3.1 (A), L1.2, R5.2
unnamed: C4.1, JP1.2 (B), R5.1, R6.2, U2.4 (FB)
unnamed: R1.2, R2.1
unnamed: R2.2, R3.1
RX0: J10.3, U1.36 (RXD0)
TX0: J10.2, U1.37 (TXD0)
