Marcel-Kitzbichler/OpenMoverPlatform/PlatformCode/OpenMoverplatform/src/main.cpp

#include <Arduino.h>
#include "config.h" 
#include "serialManager.h"
#include "motorSet.h"
#include "compass.h"
#include <Preferences.h>

extern double MagXMin;
extern double MagXMax;
extern double MagYMax;
extern double MagYMin;

void setup(){
  Preferences preferences;
  preferences.begin("botConfig", false);
  setMotorBias(preferences.getFloat("biasL", 1.0), preferences.getFloat("biasR", 1.0), false);
  MagXMin = preferences.getDouble("magXMin", 0.0);
  MagXMax = preferences.getDouble("magXMax", 0.0);
  MagYMin = preferences.getDouble("magYMin", 0.0);
  MagYMax = preferences.getDouble("magYMax", 0.0);
  preferences.end();
  vTaskDelay(10000); // time for the jtag probe to connect
  initCompass();
  motorSetup();
  xTaskCreatePinnedToCore(serialManager, "serialManager", 10000, NULL, 1, NULL, 1);
  vTaskDelete(NULL);
}

void loop(){
  vTaskDelete(NULL);
}
