Marcel-Kitzbichler/OpenMoverPlatform/PlatformCode/OpenMoverplatform/src/emerg.cpp

#include <Arduino.h>
#include <config.h>
#include "emerg.h"
#include "motorSet.h"

void emergencyStop(){
  vTaskEndScheduler();
  Serial.println("Emergency Stop");
  setMotorL(0);
  setMotorR(0);
  while(true){
    delay(1000);
  };
}
