Marcel-Kitzbichler/OpenMoverPlatform/(commit log)

2024-11-12 added kicad project
    [OpenMoverPlatform.kicad_pcb, OpenMoverPlatform.kicad_sch]
2024-11-12 KiCad save
2024-11-14 Rough sketch of chassis
    Not really to scale
2024-11-14 added DRIVEUNIT_V1
    [Abdeckplatte.SLDPRT, Baugr1 - Abdeckplatte-1.STL, Baugr1 - Mittelplatte-1.STL, Baugr1 - Motorplatte-2.STL, Baugr1 - Spacer-1.STL, Baugr1 - Spacer-2.STL, Baugr1 - Spacer20_5mm-1.STL, Baugr1 - Spacer20_5mm-2.STL]
2024-11-15 update meshes
    [Baugr1 - Abdeckplatte-1.STL, Baugr1 - Mittelplatte-1.STL, Baugr1 - Motorplatte-2.STL, Baugr1 - Spacer-1.STL, Baugr1 - Spacer-2.STL, Baugr1 - Spacer20_5mm-1.STL, Baugr1 - Spacer20_5mm-2.STL, Baugr1 - TEST!!RAD-1.STL]
2024-11-15 updated motor mount
    [Baugr1 - Abdeckplatte-1.STL, Baugr1 - Mittelplatte-1.STL, Baugr1 - Motorplatte-2.STL, Baugr1 - Spacer-1.STL, Baugr1 - Spacer-2.STL, Baugr1 - TEST!!RAD-1.STL, Baugr1 - internal spur gear_din-1.STL, Baugr1 - spur gear_din-1.STL]
2024-11-21 added v2 driveunit
    [1stGear.SLDPRT, 2ndWheel.SLDPRT, Assembly.SLDASM, ChainAxle.SLDPRT, Chaingear.SLDPRT, Chainwheel.SLDPRT, ChainwheelAss.SLDASM, Grundplatte.SLDPRT]
2024-11-29 swx update
    [Assembly.SLDASM, Assm.SLDASM, Teil1.SLDPRT, Wheel.SLDPRT, WheelHolder.SLDPRT, Wheelasm.SLDASM, Wheelaxle.SLDPRT]
2024-12-12 added motor instance checking
2025-01-16 chain
    Added added chain design from filzer and set it to the correct length
    [Assm.SLDASM, AssmFull.SLDASM, Cover plate.SLDPRT, Panzerketten 2.SLDPRT, SideBrace.SLDPRT, Wheel.SLDPRT, Wheelasm.SLDASM]
2025-01-20 added kml sample
2025-01-21 fixed PWM
2025-04-16 added Battery Reading Intent 6
2025-04-16 updated serial Timing and fixed correct decimal
    [serialManager.cpp]
2025-04-22 added motor set
2025-05-06 Rim to WheelHolder
    Added a chain guide rail to make sure the chain doesn't slip off.
    [WheelHolder.SLDPRT]
2025-05-08 added WP Manager and compass calibration routines
2025-05-10 Connector tolerance
    Updated connector tolerances to improve fit.
    [Module Lower.SLDPRT]
2025-05-12 corrected data type saved by preferences
    [main.cpp]
2025-05-13 added setpoints to motorset
2025-05-14 control pcb v1
    [OpenMoverPlatform.kicad_pcb, OpenMoverPlatform.kicad_sch]
2025-05-16 ki cad pcb update
    [OpenMoverPlatform.kicad_pcb, OpenMoverPlatform.kicad_sch]
2025-05-16 added esp32s3 environment
2025-05-18 updated pcb to use esp32 s3 wroom 1
    [OpenMoverPlatform.kicad_pcb, OpenMoverPlatform.kicad_sch]
2025-05-30 updated to new ledc api
2025-10-23 update 2025
    [1stGear.SLDPRT, 1stWheel.SLDPRT, 2ndGear.SLDPRT, 2ndWheel.SLDPRT, 3rdGear.SLDPRT, Assembly.SLDASM, Assm.SLDASM, AssmFull.SLDASM]
2025-12-10 Fix code review issues: integer division and type-safe formatting
    [helper_cli.py, helper_gui.py]
2026-02-19 fixed some deprecated code
    [compass.cpp, endMotorTask.cpp, goTo.cpp, main.cpp, motorSet.cpp]
